headgoss/L3_bracelet_de_Chute/README.md

# L3_bracelet_de_Chute
Projet en groupe dee quatre effectué en 3ème année de licence.

Le projet avait pour but de détecter la chute d'une personne âgée ou sportive et d'agir en conséquence.
