headgoss/L3_bracelet_de_Chute/Braclet_de_Chute.pdf

# Rapport projet

# Bracelet de chute

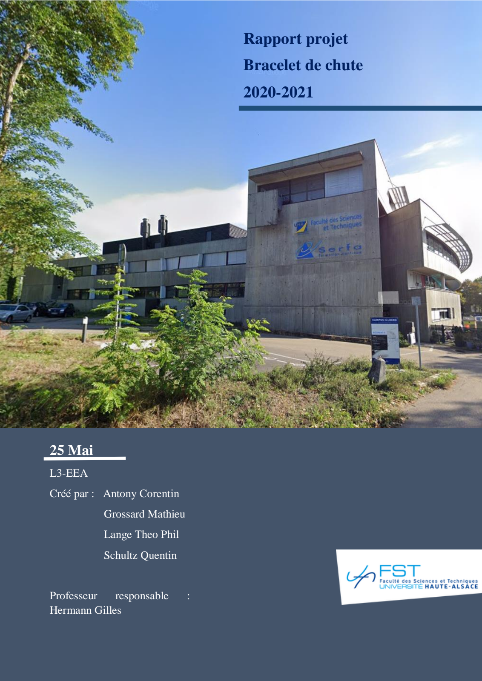
[picture p1: page 1]

Antony Corentin, Grossard Mathieu | Licence 3 EEA
Lange Theo Phil, Schultz Quentin

Bracelet de Chute

2020-2021

## 25 Mai

### L3-EEA

### Créé par : Antony Corentin

### Grossard Mathieu

### Lange Theo Phil

### Schultz Quentin

Professeur | responsable | :

### Hermann Gilles

## Les remerciements :

Nous sommes Corentin Antony, Theo Phil Lange, Mathieu Grossard et Quentin Schultz. Nous sommes ensemble pour travailler sur notre projet qui est un bracelet de chute.

Nous tenons à remercier toutes les personnes actives sur les différents forums Arduino qui nous ont permis de peaufiner notre code pour le projet ainsi que les différentes fiches techniques de nos modules qui possèdent pour la plupart un code de démarrage.

Ainsi que le corps enseignant, plus particulièrement Mr. Hermann qui nous a imprimé notre boîte et nous a conseillé sur certains branchements de nos composants.

## Sommaire

## Introduction :

Nous avons dû pendant cette période restreinte de la Covid-19 réfléchir sur une thématique de détecteur de chute pour certaines personnes qui sont à notre choix. Pour cela en début n’ayant pas le matériel disponible, nous avons réfléchi sur ce projet à distance en utilisant Discord pour pouvoir communiquer entre nous. Mais aussi choisir le but du projet, les personnes visées ainsi que de son fonctionnement recherché.

Nous sommes partis sur un bracelet de chute pour un certain groupe d’âge qui sera décrit plus loin. Ce bracelet de chute a été voulu pour ressembler à une montre pour que la personne puisse la porter sur son poignet. Ce rapport va donc contenir notre démarche de réflexion sur ce projet.

Nous allons alors parler de notre étude sur le projet, comme le public visé, puis nous verrons les étapes de réalisation du projet. Et enfin, le bilan de cette étude.

## 1. Contexte et cahier des charges :

Nous avons pour but du projet de détecter une chute qui concerne les personnes âgées. C’est-à-dire que lorsque la personne tombe, il se peut qu’elle ne puisse plus se lever. Pour cela notre bracelet est prévu pour communiquer avec une centrale qui prévient les autorités compétentes ou les proches. Si un jour le produit pourrait sortir, les clients pourrait bénéficier le bracelet pour X prix, et par exemple d’un abonnement de 10€ par mois.

Pour cela nous avons fait plusieurs choix ou plutôt nous imposer des contraintes. Nos choix ou contraintes sont :

- Les personnes âgées sont des personnes actives alors pour cela si elles se déplacent hors de leur maison nous sommes censés pouvoirs les localiser ;
- Elles n’ont peut-être pas d’appareils de communications, c’est-à-dire dans notre cas un téléphone portable pour prévenir la centrale ;
- Si le bracelet envoie un message mais que la personne se fait aider ou se relève toute seule elle doit avoir la possibilité d’informer que tout va bien ;
- Cependant, si c’est une erreur elle doit être aussi capable de le dire ;
- Mais si elle a besoin d’aide car elle ne se sent pas bien, elle peut avoir la possibilité de prévenir ;
- Et pour finir, un moyen capable de prévenir les personnes aux alentours à l’aide d’un son ;

Il s’agit donc de toutes les contraintes que nous nous sommes dans un sens imposées lors de l’élaboration du projet.

## 2. Etudes :

Nous allons dans cette partie expliquer notre procédé de réflexion pour notre étude. Que cela concerne notre démarche de réflexion du public visé, le fonctionnement voulu de notre projet et donc nous aurons une grande partie avec les différents composants utilisés.

Cette partie comportera le but d’utilisation du composant, ce que nous avons souhaité faire, ce qui a pu être fait et ce que l’on n’a pas pu réaliser finalement.

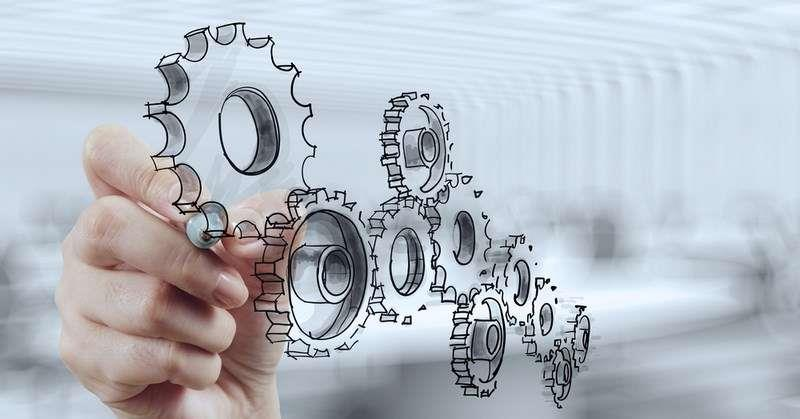
[picture p2: figure]

## 2.1. Public visé :

Nous avons à un moment donné dû nous poser pour discuter du type de public visé. Notre public serait-il un public âgé ou sportif. Après une étude du marché nous nous sommes rendu compte qu’il serait plus important de viser un public âgé, notamment à cause de la hausse de cette tranche d’âge et aussi de personnes dépendantes.

Par contre les sportifs sont moins dépendants de ce genre de produit même s’il y en a une demande celle-ci est moins importante et surtout au vu des situations de confinements répétitifs la cible de l’étude est mieux axée pour une tranche d’âge nécessaire pour leur protection.

Puisque nous avons choisi de viser les groupes de personnes âgées nous devions donc décider de leur besoin, comment l’utiliser et d’autres contraintes. Ainsi nous avons d’abord discuté de la forme que cela devrait prendre et nous nous sommes concentrés pour un bracelet type montre. Etant donné qu’elle est plus utilisée qu’une ceinture ou encore un collier. Nous avons dû décidé de la manière de communiquer et celle-ci a pris plus de temps, car on a dû se concerter pour se mettre d’accord entre le choix d’une personne à mobilité réduite ou une personne dynamique mais risquant de faire des chutes. Au final nous avons choisi une personne pouvant se déplacer, cela signifiait que l’on n’allait pas faire une communication entre deux appareils dont l’un par un moyen ou un autre communique aux urgences. Donc nous avons décidé d’utiliser une communication par GSM¹
c’est-à-dire une communication numérique à l’aide d’une carte SIM¹

Comme nous avons décidé de viser les personnes âgées en mouvement nous devons être capable de la localiser. C’est pourquoi nous avons intégré un GPS¹
qui utilise les satellites pour repérer la personne, ainsi ces coordonnées seront envoyées par SMS. Nous avons rajouté un buzzer pour informer les personnes aux alentours afin qu’ils puissent se rendre compte que la personne est tombée.

Finalement nous avons aussi rajouté deux boutons, un bouton pour annuler l’envoi de SMS. L’autre bouton au cas où la personne a besoin d’aide même si elle n’est pas tombée.

1 P.26

## 2.2. Composants utilisé :

### Carte Arduino NANO :

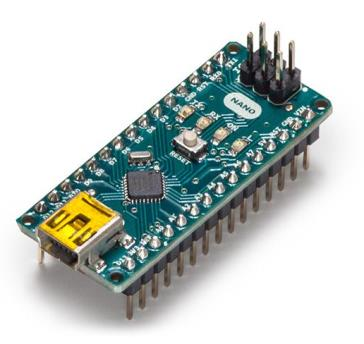
[picture p3: figure]

Nous avons décidé d’utiliser comme microcontrôleur la carte d’Arduino NANO par son prix faible et sa petite taille mieux adaptée pour notre étude. Malgré son coût plus faible il ne faut pas croire à une faible performance. Au contraire l’Arduino NANO possède 14 pins digitaux à travers lesquels elle fournit 40 mA² maximum. En outre, elle intègre 2 pins analogiques de plus que la UNO. Cela fait donc 8 pins analogiques pour la Nano. En ce qui concerne la capacité, elle est dotée d’une mémoire Flash² de
32Kb²

et 2Kb²
de mémoire dynamique. En utilisant le pin 30 on peut connecter une alimentation externe comprise entre 6 et 20 Volt²
que l’on abordera plus tard.

Le choix de la NANO est aussi en occurrence avec l’environnement de travail qui est Arduino IDE. Celui-ci nous permet de créer nos programmes et de les transférer à la carte à l’aide de la prise USB. Mais cela est aussi en corrélation avec nos études puisque nous avons depuis le début de cette année utilisé cette interface pour la programmation robotique ou de projet.

2 P.26

### Accéléromètre et gyroscope 3 axes :

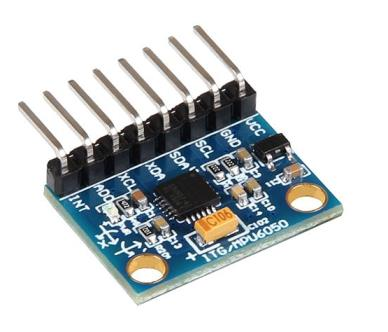
[picture p4: figure]

Nous utilisons l’accéléromètre pour détecter en partie la chute ou tout du moins une accélération rapide du mouvement. Nous pouvons sans aucun doute dire que c’est notre capteur le plus important et le plus essentiel à la réalisation de notre projet car c’est lui qui nous détecte principalement si nous avons une chute ou non. L’accéléromètre fonctionne avec un bus I2C³

Nous avions souhaité l’utilisé aussi pour détecter en partie des mouvements ou des gestes pouvant mettre la personne en péril. Cela signifie le fait de monter sur une chaise, un escabeau principalement. Mais certains problèmes se sont posé. Ces problèmes sont pour la plupart une lecture des données brutes retransmise par l’accéléromètre et les adapter à nos besoins.

Nous avons uniquement réussi à détecter une accélération et un choc et non de prévenir un risque pouvant mettre en danger la personne. Nous supposons que cela vient de différents facteurs comme le fait que nous le portons sur le poignet ainsi si une personne lève son bras notre bracelet détecterait aussi un risque. Nous avons aussi le problème de monter des escaliers puisque le principe serait le même que monter une échelle. C’est-à-dire une avancée en x et y par exemple.

Au final nous avons réussi à transformer les valeurs brutes en valeur à étudié et avec quelque test de simulations nous avons pu déclarer une sensibilité de chute à 23. {Cf. Sensibilité du capteur avec différentes études}

3 P.26

### Capteur de vibrations :

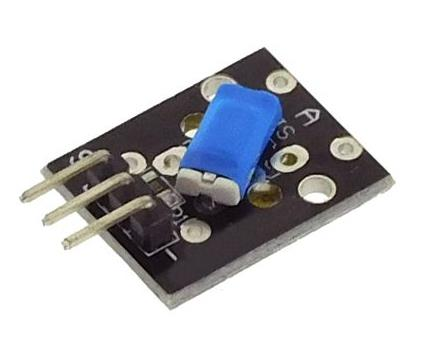
[picture p5: figure]

En complément de l’accéléromètre nous avons décidé d’utiliser un capteur de vibrations. Celui-ci est censé nous faire une confirmation de la chute. L’idée que nous avions eue, c’est que l’accéléromètre peut nous permettre de détecter une accélération mais pas sûr pour une chute alors on complète le montage avec un deuxième capteur, le capteur de vibrations qui va détecter les vibrations dues au choc. Par contre en pratique certains problèmes se sont posé.

Les problèmes que l’on a rencontrés sont en fait dû au fonctionnement lui-même du capteur de vibrations. Celui-ci fonctionne concrètement par le roulement d’une bille et est censé changer d’état lors de vibrations ou choc assez fort. Le problème c’est qu’il fonctionne très bien mais que dans une position donnée car si on le change la bille va pas se trouver au bon endroit et sera toujours en état haut. C’est-à-dire que le détecteur va toujours détecter des vibrations.

Nous avons donc dû essayer de la placer le mieux possible dans notre montage mais aussi adapter au mieux notre code puisqu’il est en quelque sorte la deuxième sécurité même s’il est possible que le code final ne l’utilise pas. Au final pour notre projet nous avons retiré ce capteur car il n’est pas adapté à ce type d’études puisqu’il est mieux adapté pour un déplacement d’un seul axe.

### Module GPS⁴ Grove :

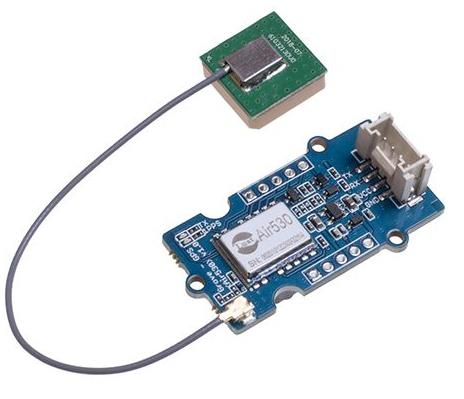
[picture p6: figure]

Pour la détection de la personne âgée qui est toujours mobile nous avons donc décidé d’utiliser un module GPS⁴
qui utilise les satellites pour obtenir des coordonnées mais ces coordonnées sont fausses dans le cas où la personne est en intérieur. C’est pourquoi le standard est formé pour pouvoir reconnaitre de bonnes coordonnées ou des mauvaises et bien diriger les urgences. Le GPS⁴
fonctionne en
communication série avec RX et TX.

Je parle de standard car on envoie un message à l’aide d’un module que l’on verra plus tard. Ce message comprend le message je suis tombé suivi d’une trame complète qui est la trame des coordonnées. Nous n’avons pas réussi à extraire uniquement les coordonnées GPS⁴
c’est pourquoi on
s’est rabattu sur la deuxième solution qui est d’envoyer le moins d’informations nécessaires. Pour cela on extrait uniquement la trame la plus importante celle qui contient les coordonnées GPS⁴
et ceci sera
inclus dans un message qui sera envoyé au standard qui est formé à lire et utiliser ses coordonnées.

Le standard est adapté à comprendre ces messages et à répondre au différent modèle qui seront selon le client, prévenir uniquement les proches, prévenir juste les urgences ou prévenir les deux mais d’autres cas peuvent se passer que l’on verra plus loin.

4 P.26

### Buzzer :

Nous avons choisi d’utiliser un buzzer dans le but de prévenir la personne âgée que son bracelet à détecter une chute au cas où ce ne serait pas le cas, juste un mouvement trop brusque par exemple.

Le second but est de servir comme prévention pour les personnes aux alentours. Sachant que nous sommes sur une personne mobile. Elle peut faire ses courses toute seules, sortir se promener ou aller chez des proches. Le buzzer permettrait alors de faire réagir les personnes aux alentours qu’il y a un souci dans la même optique qu’un bracelet d’alarme de sécurité.

Nous n’avons pas rencontré de problème lors de l’utilisation du buzzer puisque son principe est simple. Une tension d’entrée permet de faire sortir un son du buzzer. Ayant un principe si simple la programmation n’a pas été compliqué. Le seul petit problème est lors de la création de la boîte qui est de faire un espace vide pour permettre que le son puisse sortir de la boîte et que l’on peut l’entendre. Cette boîte sera dans une autre partie qui vient plus tard.

### Bouton poussoir :

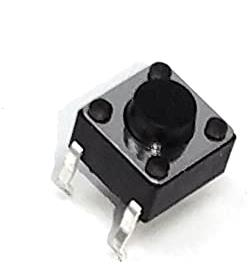
[picture p7: figure]

Nous avons décidé d’intégrer à notre étude deux boutons poussoir. Chaque bouton a une utilité différente. Ces deux boutons se trouvent à gauche et à droite de l’écran OLED que l’on verra plus tard. L’un des boutons sert à annuler l’envoi des messages avant qu’il parte dans le cas où elle peut se relever ou si on l’aide. L’autre est utilisé par danger ou mauvaises situations. C’est-à-dire si la personne ne se sent pas bien même si elle n’est pas tombée ou si par exemple elle ne peut plus bouger par faiblesse.

Le fonctionnement des deux boutons est très simple puisqu’il joue sur une interruption. Lorsque l’on appuie sur le bouton un changement d’état arrive. Ce changement pris en compte va diriger l’envoie de message. Dans le cas du bouton pour d’interruptions du message on aura un temps donné pour laisser la possibilité à la personne d’interrompre l’envoie du message dans le cas d’une chute comme le fait d’appuyer sur le SOS. Dans l’autre cas « SOS ! » suivi des coordonnées GPS que le standard saura utiliser.

Nous n’avons pas eu de problèmes lors de l’utilisation de ces deux boutons puisque leur principe est le même qui est une interruption suivie d’un message. Seulement les messages peuvent être différents. L’utilisation des interruptions a en plus été bien traiter peu de temps avant le projet donc leur utilisation n’était pas une découverte.

### Module GSM⁵

:

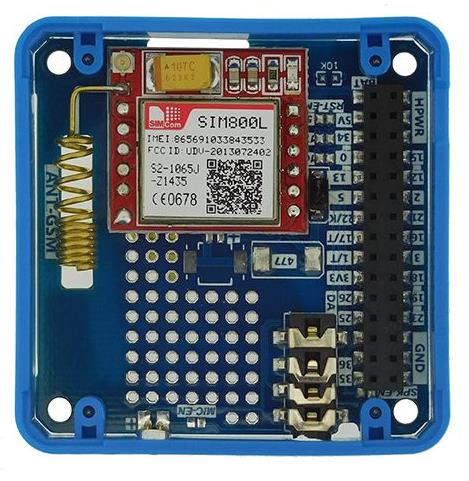
[picture p8: figure]

Comme mentionné plus tôt la communication doit pouvoir se faire à n’importe quel moment et si possible n’importe où. C’est pour cela que l’on utilise un module GSM⁵

utilisant une carte SIM⁵
. Ce
module nous permet de contacter la centrale qui possède les numéros des clients et est formée pour réagir au différent message pouvant arriver. Le GSM⁵
communique en série avec RX et TX comme le GPS⁵

Puisque nous avons décidé de créer des fonctions pour tester le fonctionnement de chaque composant à part nous avons rencontré un problème sur le GSM⁵
. Ce problème était un problème de consommation. Lors de nos recherches et tests, la plupart de nos camarades de classe réussissait à envoyer un SMS alors que les pins de l’Arduino ne peuvent transmettre que 40mA⁵ maximum. Cela nous paraissait étrange sachant que la consommation du module est inférieure à 350mA⁵

et jusqu’’à 2A⁵
en pic(appel).

Pour pallier ce problème on utilise un autre composant qui est un régulateur ajustable 1,25 à 30 Vcc. Ce régulateur une fois ajouté au projet et liant notre Arduino au GSM⁵
nous permet de fournir assez d’intensité (jusqu’à 3A) pour pallier la consommation du GSM⁵
qui est supérieure à ce que peut délivrer l’Arduino.

5 P.26

### Afficheur OLED⁶

:

L’afficheur OLED⁶

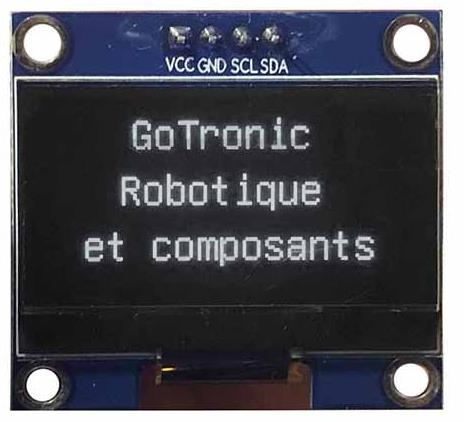
[picture p9: figure]

nous permet de vérifier le bon fonctionnement du bracelet, puisque l’on a décidé qu’il sera toujours allumé même si malheureusement cela influence sa durée de vie. Nous avions voulu utiliser l’afficheur dans le même principe que l’écran d’une montre mais nous nous sommes rendu compte qu’il nous manquait un composant pour rendre cela possible. Pour pallier cela on n’affiche que le but du bracelet et selon laquelle des situations arrivent l’affichage change. L’OLED⁶
fonctionne avec
un bus I2C⁶
comme on peut le voir avec SCL et SDA sur l’image ci-dessus.

Le seul problème rencontré a été d’apprendre à l’utiliser puisque celui-ci fonctionne avec une librairie qui est la U8glib. Nous avons vite trouvé comment faire un programme simple avec sur un blog web. Même s’il est vrai qu’avant de l’utiliser on a cherché à comprendre son fonctionnement. Puisque celui-ci est très différent d’un un écran LCD Grove utilisé en TP.

6 P.26

### Batterie :

La pile de 9V⁷

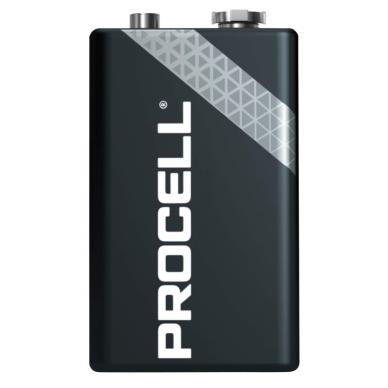
[picture p10: figure]

a été notre choix pour un prototype de notre bracelet. Notre raison est la tension à fournir en batterie externe qui doit être entre 6 et 20 Volts pour faire fonctionner l’Arduino. En plus de cela il est plus simple de trouver en grande surface une pile 9V et un chargeur pour pouvoir en cas de décharge avoir une possibilité efficace de changer la batterie.

Après étude la pile procell que nous utilisons pour le prototype possède 673 mAh⁷
. La pile a
pour notre projet une faible autonomie mais selon le calcul de la consommation qui est capacité de la pile / consommation de l’appareil = autonomie en heures. On choisit d’utiliser pour l’autonomie le principe que le GPS⁷ et le GSM⁷
sont en veille la plupart du temps et nous donnons donc la durée d’autonomie la plus grande du bracelet.

Soit consommation de l’appareil = arduino (9.2) +accéléromètre (3.9) +capteur de vibration (1) + OLED (25) + GSM (1.2) + GPS (0.85) = 41.15mAh. Ainsi la durée de vie maximum pouvant être atteinte avec juste quelque composant toujours actif nous avons autonomie = 673/41.15 =16 heure environ. Il faut prendre en compte que cette durée est possiblement considérée comme assez longue mais en pratique l’autonomie est plus petite puisque si on considère qu’un message n’est pas envoyé mais que le GPS⁷

est actif, on a par exemple 88.3mAh⁷ soit une autonomie d’environ 8 heures et si un message est envoyé cette autonomie est encore plus petite.

7 P.26

### Totale :

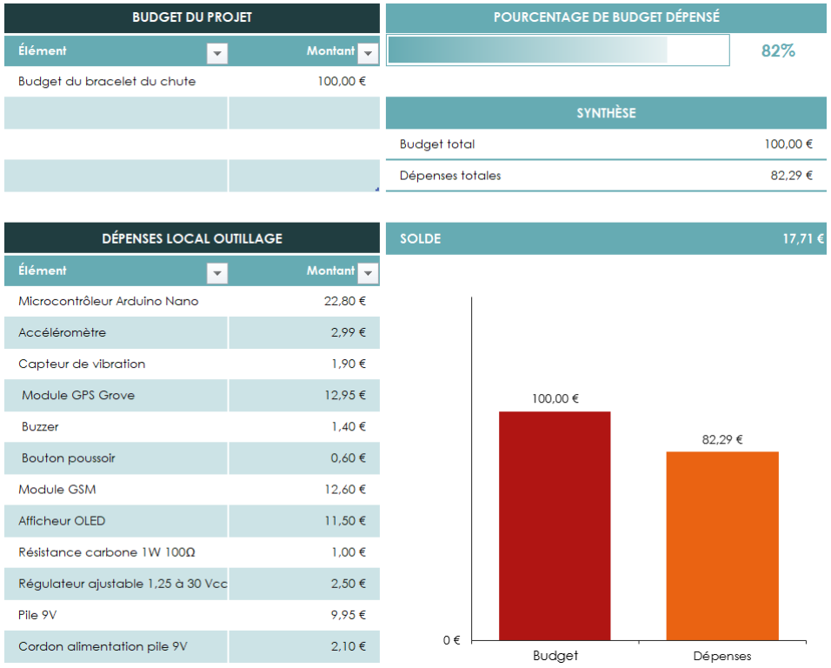
[picture p11: figure]

L’analyse nous montre que le budget initial a été respecté puisque le budget de départ est de 100€ et nous avons au final 82,29€ avec un solde restent de 17,71€. La raison pour cela c’est que nous avons voulu prendre le moins cher possible.

## 3. Réalisations :

Dans cette partie nous allons expliquer la réalisation du projet. C’est-à-dire nous allons décrire le fonctionnement de notre code dans cette étude. Ses différents buts et fonctions.

Ensuite nous expliquerons la démarche que nous avons eue pour la réalisation du contenant pour ce prototype et pourquoi nous l’avons fait de telles manières.

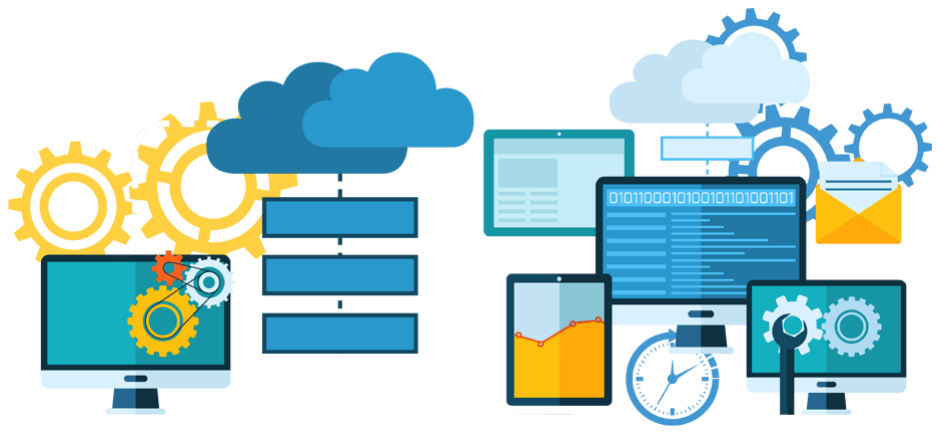
[picture p12: figure]

## 3.1. Planning :

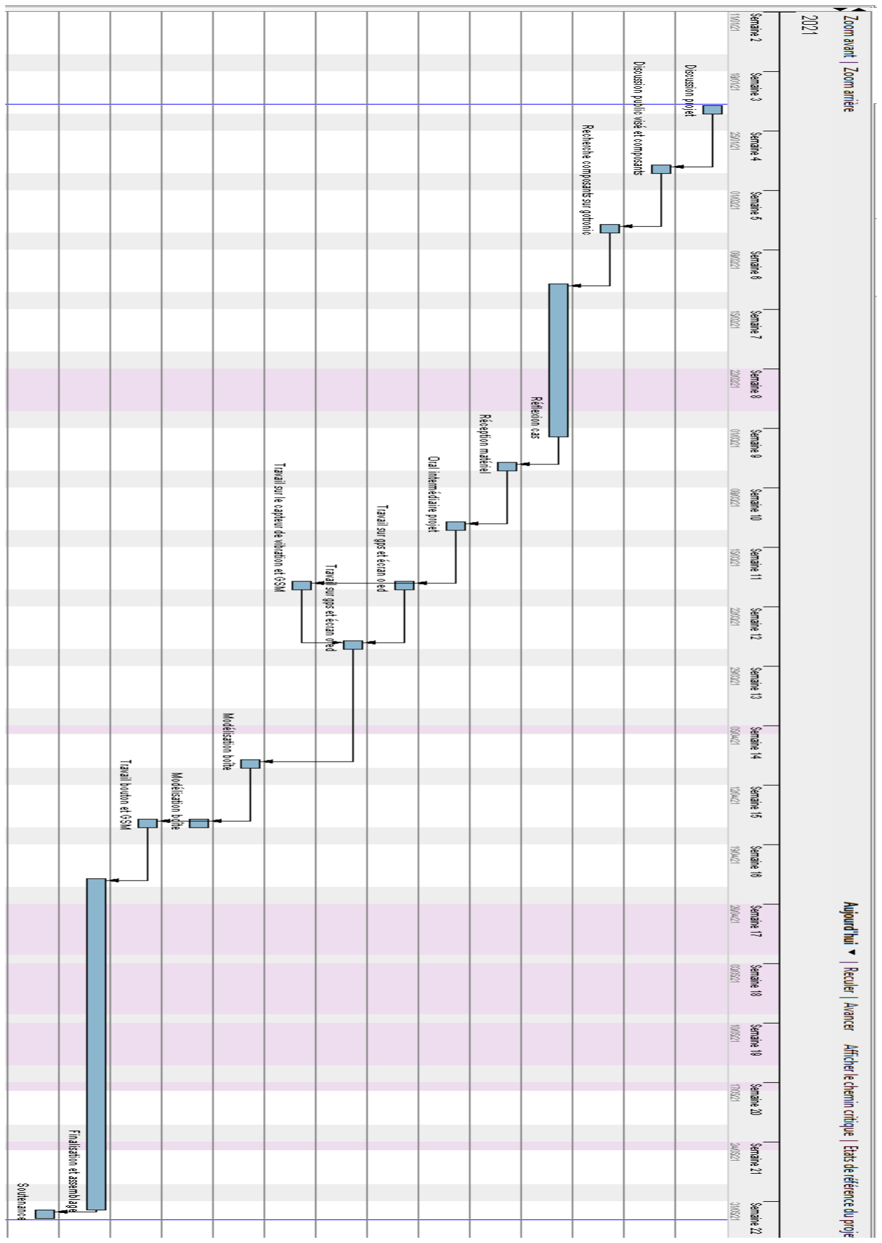
[picture p13: figure]

## 3.2. But du Fonctionnement :

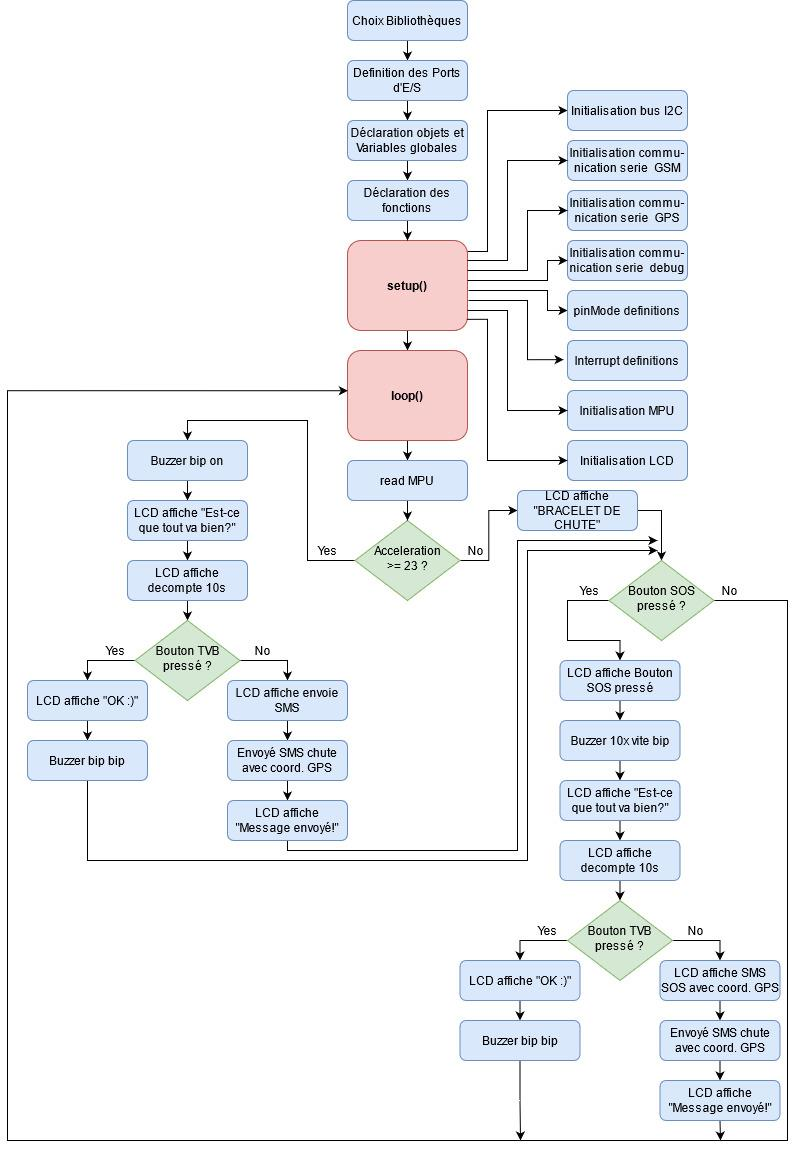
[picture p14: figure]

Tout | d’abord | commençons | par | un | organigramme | du | code :

Dans ce qui suit, je vais présenter le programme. L'ensemble du code du programme est présenté en détail à l'annexe 5.1. En Annexe 5.2 vous pouvez voir tous les écrans différents de notre bracelet de chute.

Le programme affiche à l'utilisateur "BRACELET DE CHUTE" tant qu'aucun événement ne se produit. Le MPU demande constamment quelle accélération est présente. Si cette valeur est supérieure ou égale à 23, une chute est détectée. Maintenant, le buzzer est activé et l'utilisateur est interrogé par l'intermédiaire de l'écran : "Est-ce que tout va bien ? Un décompte est affiché pendant 10s.

L'utilisateur a tout ce temps pour montrer qu'il va bien en cliquant sur le bouton TVB. S'il montre qu'il va bien, "OK :)" s'affiche sur l'écran, l'utilisateur entend deux longs bips du buzzer et le programme repart dans la boucle principale. Cependant, si le bouton TVB n'est pas pressé, un SMS est envoyé au panneau de contrôle indiquant qu'il y a eu une chute. Le SMS contient également les coordonnées GPS de l'utilisateur. Après avoir envoyé ce SMS, l'écran indiquera que le SMS a été envoyé et le programme retournera à la boucle principale.

Un appel d'urgence peut également être envoyé via le bouton SOS. Le programme demande alors si le bouton SOS a été actionné. Si le bouton SOS a été actionné, l'écran indique que le bouton a été actionné et l'utilisateur entend dix bips rapides du buzzer. Après cela, il a 10s de temps pour montrer qu'il est ok en appuyant sur le bouton TVB.

Si le bouton TVB est pressé dans les 10s, l'écran affiche "OK :)", l'utilisateur entend deux longs bips du buzzer et le programme revient à la boucle principale. Cependant, si le bouton TVB n'est pas pressé, un SMS avec "SOS" et les coordonnées GPS de l'utilisateur est envoyé au centre de contrôle. Ensuite, il est indiqué que le SMS a été envoyé et le programme retourne dans la boucle principale. Maintenant la boucle principale recommence avec la demande d'accélération de la part du MPU. Pour toute cette partie Cf. Code du projet

## 3.3. Forme Final :

Nous nous sommes réparti les tâches pour finaliser le projet. Quentin et Mathieu se sont chargé de la modélisation 3D de la boîte, quant à Corentin, il s’est occupé de souder les composants entre eux et Théo de rédiger le code final. Pour la forme finale du bracelet nous avons décidé de faire une boîte rectangulaire sur 13x9x8,35cm. La boîte est assez grande comparée à l’objectif de départ mais cela nous permet d’avoir tous nos composants à l’intérieur. Nous avons aussi fait des encoches dans le bas de la boîte pour pouvoir y monter une sangle de bracelet. Ce qui suit maintenant seront des images de la boîte en 3D numériques et ensuite réels. :

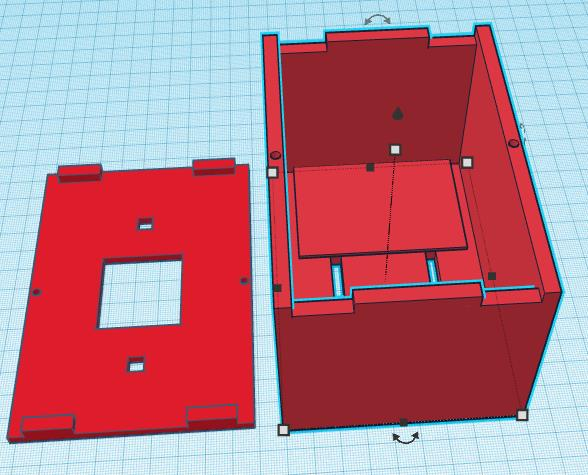
[picture p15: figure]
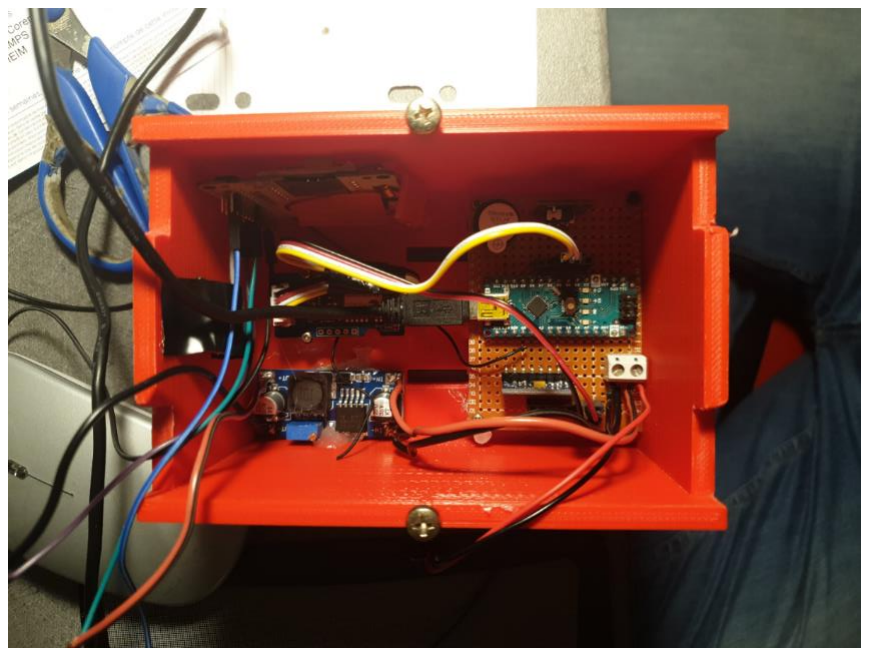
[picture p16: figure]
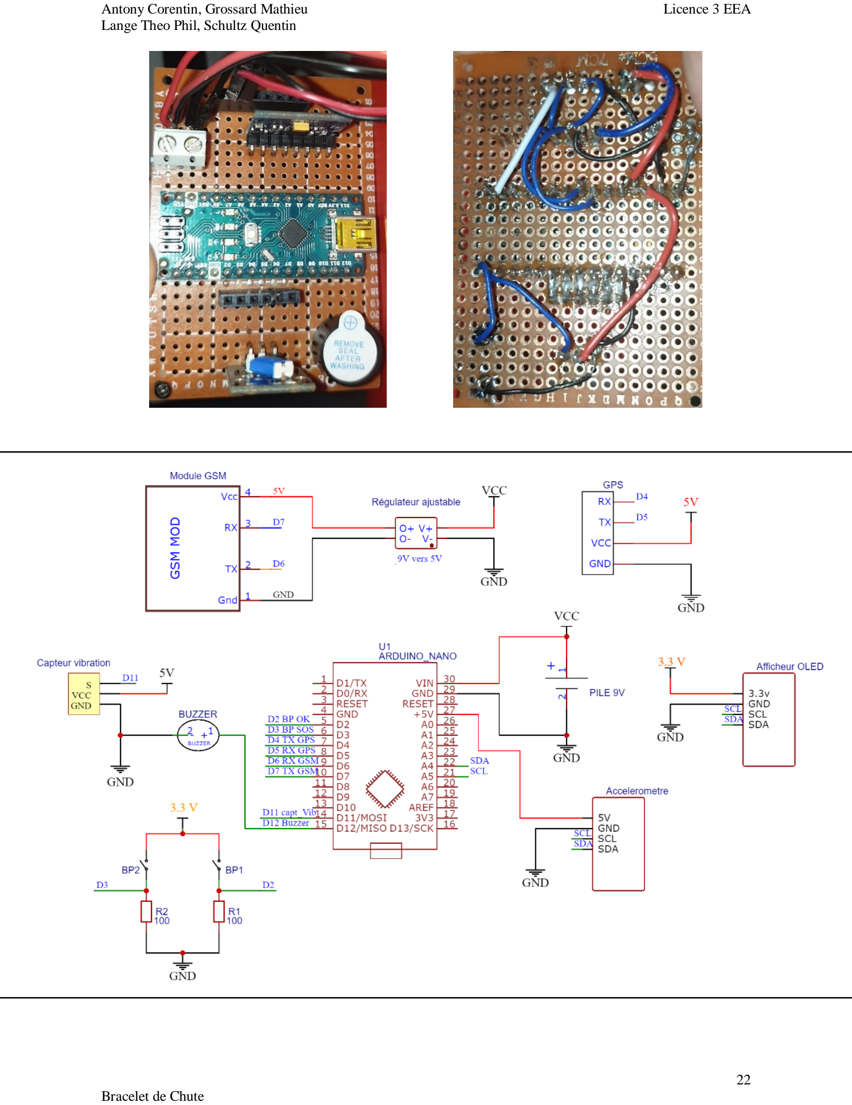
[picture p17: page 23]
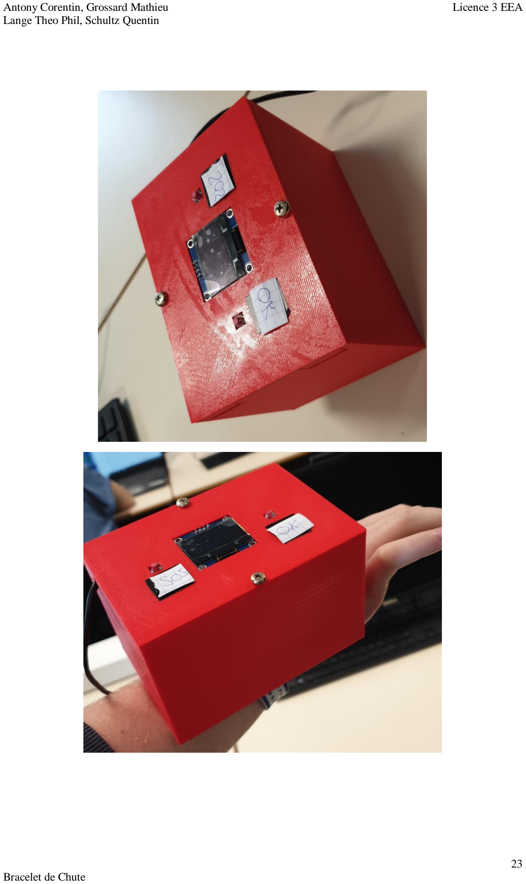
[picture p18: page 24]

## 4. Bilan et perspectives :

Nous avons choisi de créer un bracelet qui détecte les chutes pour les personnes âgées qui sont toujours en mobilité dans la vie de tous les jours. Pour cela on avait un budget initial de 100€ et nous voulions faire un prototype le plus petit possible.

En ayant ces deux points en tête nous avons eu au total une commande de 82,29€ pour l’ensemble de nos composants qui regroupe la détection de la chute, la communication ainsi que la géolocalisation. En pratique nous nous sommes rendu compte qu’un composant ne pouvait pas être utilisé dû à la forme de notre projet c’est-à-dire le capteur de vibration que l’on a remarqué à la fin lors de différents tests.

L’impact de notre projet est d’amener un sentiment de sécurité aux personnes âgées ainsi que leur entourage par ce bracelet qui permet de contacter une équipe en cas de besoin.

Au final nous avons encore un certain nombre d’améliorations qui peuvent être apportées et nous allons n’en citer qu’un certain nombre. La première amélioration est sans aucun doute la forme de la boîte, une forme plus compacte et plus ronde. La deuxième serait l’intégration d’un module d’horloge en temps réel comme le DS3231. La troisième est possiblement un capteur de choc plus adapté qui permet d’exploiter plus la vibration. La quatrième est un nouveau bouton qui permettrait de changer le mode de détection de chute, c’est-à-dire que les gestes brusques ne seront pas des chutes.

## 4.2. Conclusion :

GROSSARD Mathieu :

Le projet durant cette période, ma permit de me rendre compte encore plus qu’avant l’importance d’une bonne répartition des tâches de travail pour un avancement efficace et intéressant d’un projet que ce soit au niveau professionnel ou personnel. Cela m’a aussi permis de faire quelque rappel et complément sur la création de contenant 3D. Tout en complémentant mon savoir-faire sur la programmation et d’intégrer plusieurs petits codes pour en créer un grand qui gère toutes les conditions voulu lors de la création.

LANGE Theo Phil:

Le projet m'a beaucoup aidé à améliorer mes compétences linguistiques. Grâce au travail permanent avec d'autres étudiants, j'ai pu avoir des contacts fréquents pendant la situation de Corona et nous avons bien travaillé ensemble et aussi ri.

J'aime vraiment travailler sur des projets, développer et mettre en œuvre des idées. C'était donc amusant pour moi de développer le projet de plus en plus loin et d'être capable de livrer un appareil fonctionnel à la fin.

Les projets sont également un bon moyen pour moi de pratiquer la structure et la planification. Dans l'ensemble, j'ai pu acquérir beaucoup d'expérience.

Schultz Quentin :

Ce projet est une bonne introduction pour la continuité de mes études, en particulier au niveau du travail en groupe. Ce projet a été très formateur, il a permis de mobiliser des connaissances acquises au cours de notre formation et d'explorer de nouveaux domaines non enseignés comme avec Gantt. Les différentes recherches que nous avons faites ont été très enrichissantes. Cela nous a permis de prendre conscience de l'importance de considérer les diverses parties prenantes lors de la réalisation d'un projet et les réalisations du code et de la modélisation de la boîte.

ANTONY Corentin :

Ce projet s’est révélé très enrichissant dans la mesure où il a consisté en une approche concrète de notre formation, nous avons pris les devants en proposant notre propre vision du projet en le réalisant de A à Z. De plus, ce projet nous a permis d’appliquer nos connaissances en électronique, programmation Arduino et même en soudure. Malgré cette période nous avons fait de notre mieux afin de finaliser au maximum ce projet en nous répartissant équitablement les tâches. Même si le temps fut bref, j’ai aimé travailler avec mes camarades et ça a été pour moi une belle expérience.

## 4.3. Lexique :

Ampère : L'ampère (symbole A) est l'unité de mesure du Système international d'unités de l'intensité du courant électrique. Un courant d'un ampère correspond au transport d'une charge électrique d'un coulomb par seconde à travers une surface.

E/S : E/S correspond à entrer et sortie, ici cela correspond au différent pin de l’Arduino qui seront déclaré comme une entrée d’informations ou une sortie d’informations.

GPS : Le Global Positioning System (GPS) est un système de géolocalisation mondial. Ainsi, grâce aux satellites et à des récepteurs appelés également GPS, une personne peut non seulement savoir où elle se trouve de façon très précise mais également trouver son chemin pour aller à un endroit.

GSM : Abréviation (https://www.linternaute.fr/dictionnaire/fr/definition/abreviation/) de (https://www.linternaute.fr/dictionnaire/fr/definition/de-1/) Global (https://www.linternaute.fr/dictionnaire/fr/definition/global/) System (https://www.linternaute.fr/dictionnaire/fr/definition/systeme/) for (https://www.linternaute.fr/dictionnaire/fr/definition/for/) Mobile (https://www.linternaute.fr/dictionnaire/fr/definition/mobile/) communication, (https://www.linternaute.fr/dictionnaire/fr/definition/communication/) qui (https://www.linternaute.fr/dictionnaire/fr/definition/qui/) désigne (https://www.linternaute.fr/dictionnaire/fr/definition/designer/) un (https://www.linternaute.fr/dictionnaire/fr/definition/un/) téléphone (https://www.linternaute.fr/dictionnaire/fr/definition/telephone/) portable. (https://www.linternaute.fr/dictionnaire/fr/definition/portable/)

I2C : Inter Integrated Circuit développé au début des années 80 par Philips Semiconducteur pour permettre de relier facilement à un microprocesseur les différents circuits d’un téléviseur moderne. Son But : faire communiquer entre eux des composants électronique très divers grâce à seulement 3 fils : Signal de donnée : SDA ; Signal d’horloge : SCL; Signal de référence électrique : masse

SIM : Une carte SIM (de l'anglais : subscriber identity/identification module) est une puce contenant un microcontrôleur et de la mémoire. Elle est utilisée en téléphonie mobile pour stocker les informations spécifiques à l'abonné d'un réseau mobile1, en particulier pour les réseaux GSM, UMTS et LTE.

Kb : Un kilobit est une unité d'information (symbole kbit ou kb). La valeur standard d'un kilobit est 10^3 bit = 1 000 bit. Les kilobits sont généralement utilisés pour exprimer la vitesse de communication numérique

Mémoire Flash : La mémoire flash est une mémoire de masse à semi-conducteurs réinscriptible, c'est-à-dire une mémoire possédant les caractéristiques d'une mémoire vive mais dont les données ne disparaissent pas lors d'une mise hors tension. La mémoire flash stocke dans des cellules de mémoire les bits de données qui sont conservées lorsque l'alimentation électrique est coupée.

OLED : Oled est l'acronyme de Organic Light-Emitting Diodes (en français, Diode électroluminescente organique). Un film organique (composé carboné) est pris en sandwich entre deux autres films jouant le rôle d'électrodes. Lorsqu'un courant est appliqué, le composé organique s'illumine.

Volts : Le volt (symbole : V) est une unité, de force électromotrice et de différence de potentiel (ou tension) et dérivée du SI.

## 4.4. Webographie :

Réalisé par Steeve et Hervé, https://www.redohm.fr/2015/03/utilisation-du-module-gps-grove-sen10752p/, (https://www.redohm.fr/2015/03/utilisation-du-module-gps-grove-sen10752p/) 10 avril 2021, Utilisation du module GPS Grove SEN10752P

Réalisé | par | tiptop | administrateur | du | site,
http://tiptopboards.free.fr/arduino_forum/viewtopic.php?f=2&t=28, 9 avril 2021,

Module gyroscope et accéléromètre MPU6050 6 axes + Arduino

Réalisé | par | Path, | https://www.robot-maker.com/forum/topic/12105-detecter-les-
collisions-avec-un-accelerometre/, (https://www.robot-maker.com/forum/topic/12105-detecter-les-collisions-avec-un-accelerometre/) 3 avril 2021, Détecter les collisions avec un accéléromètre

Réalisé par Iglinux, http://lglinux3d.e-monsite.com/pages/arduino/arduino.html, 5 mars 2021, Arduino avec Oled ssd1306 et U8Glib

Un Wiki donc pas trouvé l’auteur, https://wiki.seeedstudio.com/Grove-GPS/, 19 février 2021, Grove – GPS

Réalisé par jojo, https://www.circuitstoday.com/interface-gsm-module-with-arduino, 23 avril 2021, How to Interface GSM Module to Arduino-Send and Receive SMS

## 5. Annexe

## 5.1. Code du projet

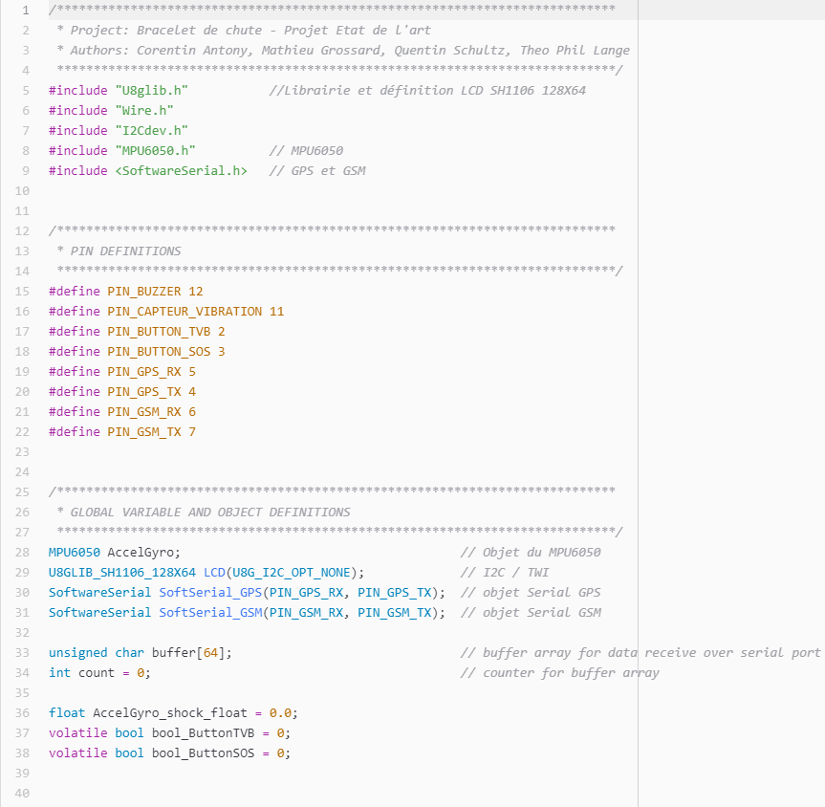
[picture p19: figure]
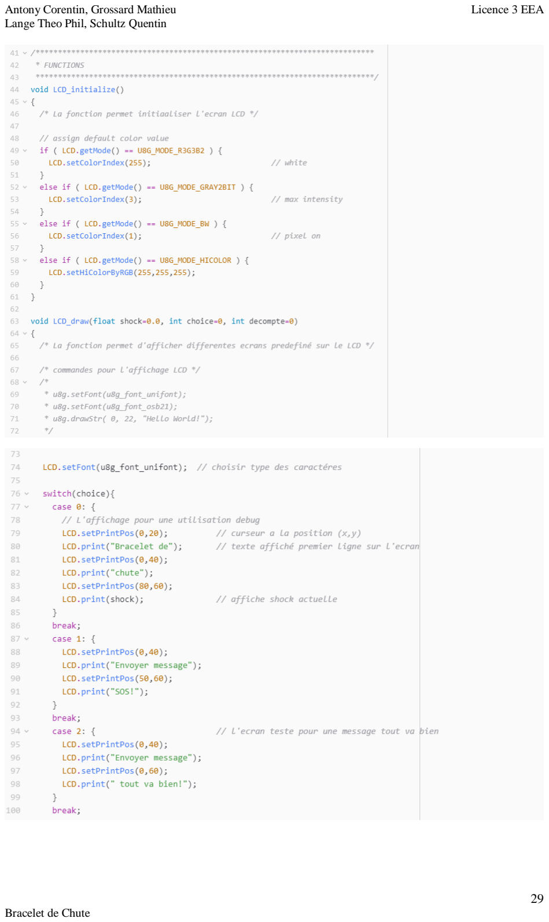
[picture p20: page 30]
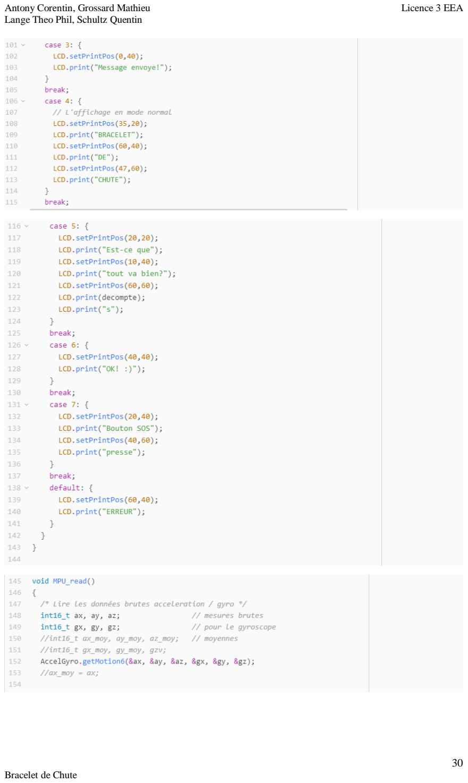
[picture p21: page 31]
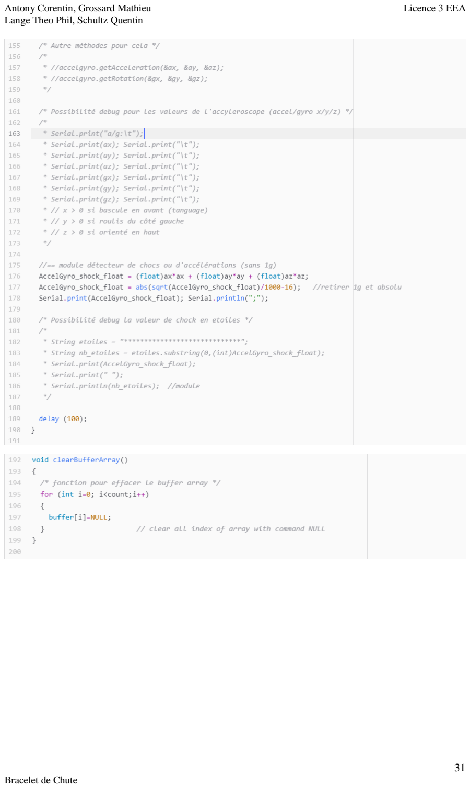
[picture p22: page 32]
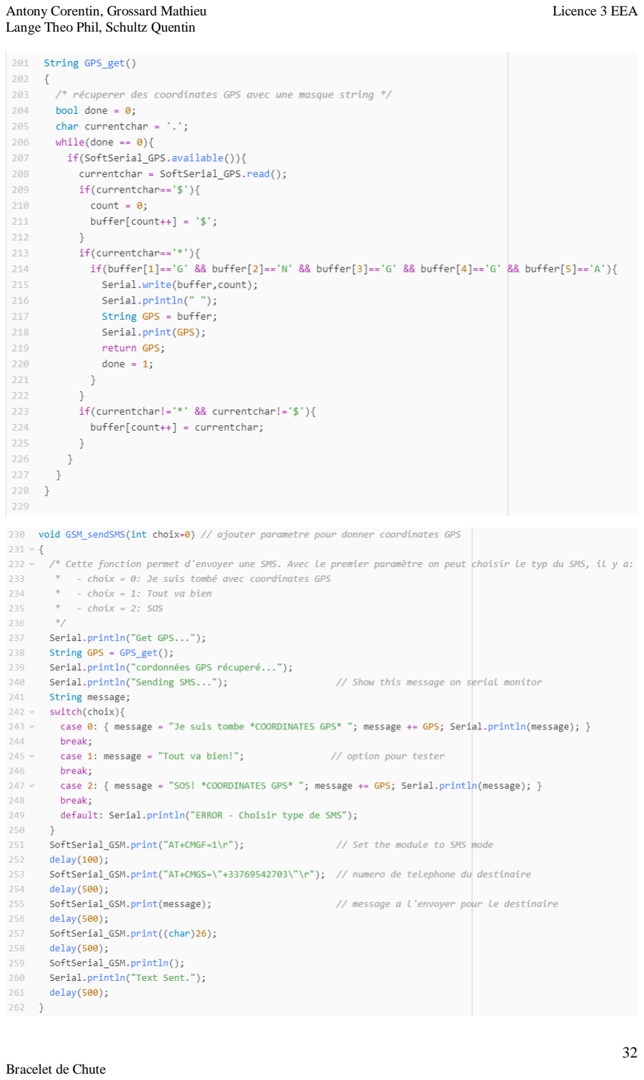
[picture p23: page 33]
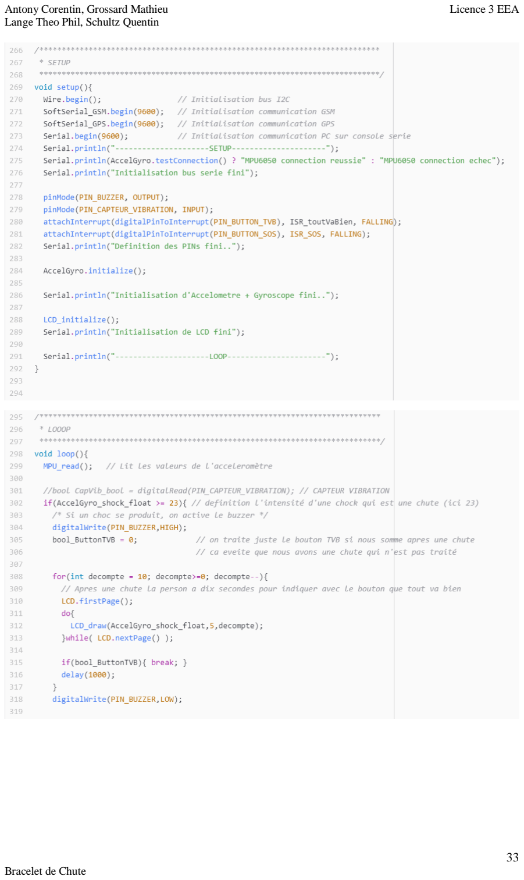
[picture p24: page 34]
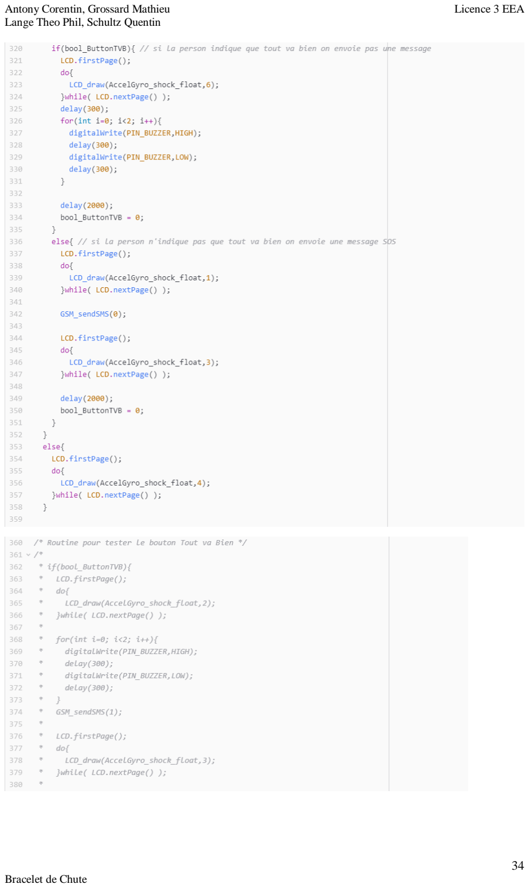
[picture p25: page 35]
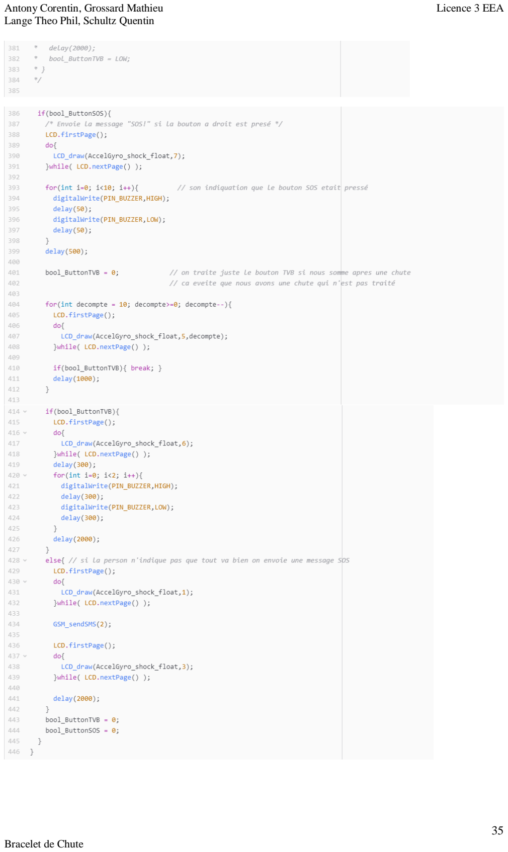
[picture p26: page 36]
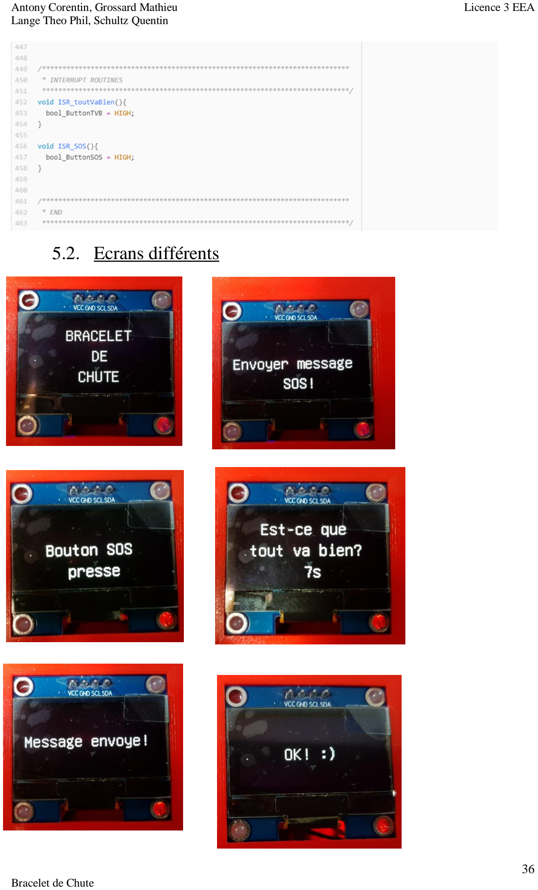
[picture p27: page 37]

## 5.2. Ecrans différents

## 5.3. Sensibilité du capteur avec différentes études

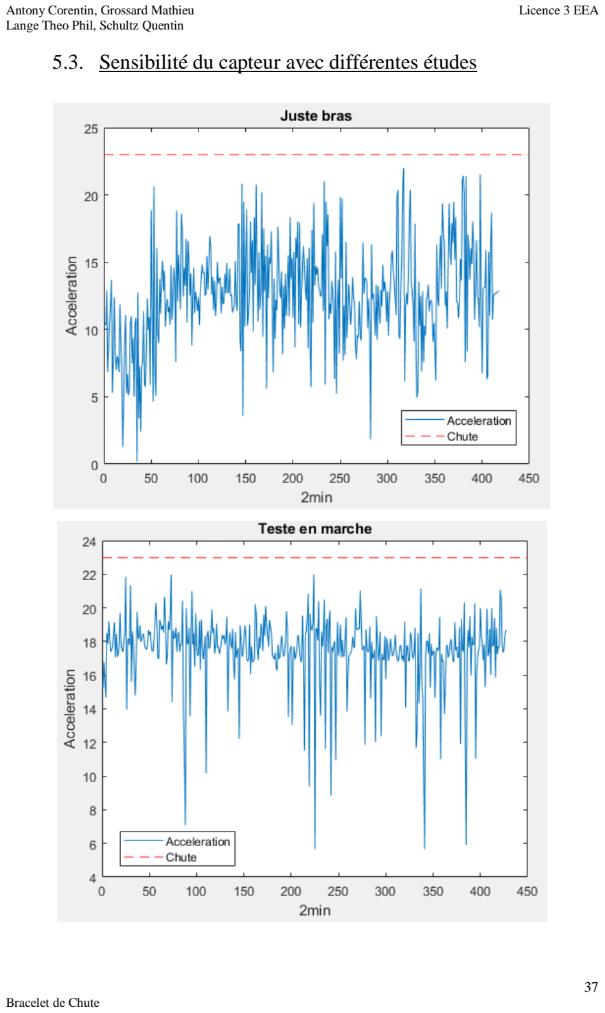
[picture p28: page 38]

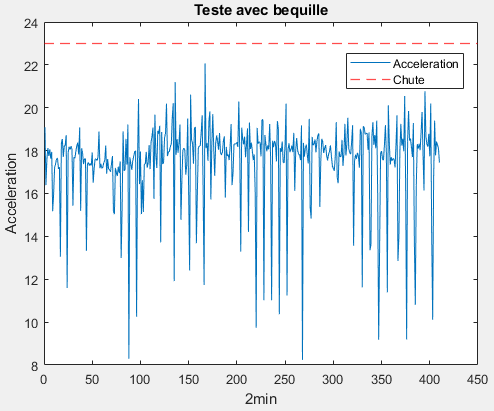
[picture p29: figure]
